dazchi/bx-tacho/firmware/README.md

# BX Tacho firmware

ESP-IDF **v6.1** firmware for the BX Tacho v0.2 board (ESP32-C3-WROOM-02).
Spec: `HANDOVER.md` section 6.

## Build and flash

In VS Code with the ESP-IDF extension, open **this `firmware/` folder** (not the
repo root), select the serial port of the board's USB Serial/JTAG, then run
**ESP-IDF: Build, Flash and Monitor**.

From an ESP-IDF terminal:

```
idf.py build
idf.py -p COMx flash monitor
```

If automatic download mode fails, hold BOOT (SW3), tap RESET (SW2), release BOOT.

`idf.py flash` writes the bootloader, the partition table, the app and a blank
`otadata`. Flashing by hand, write `otadata` with the app: with two app slots,
an app written alone at 0x10000 doesn't boot if the board last ran the other
slot.

```
python -m esptool --chip esp32c3 -p COMx -b 460800 write-flash 0x10000 build/bx-tacho.bin 0x10e000 build/ota_data_initial.bin
```

A board that still has the older single-app partition table needs the full set
once (`idf.py flash`, or the web app's USB update, which always writes it).

## Release build

The normal build is for debugging (`-Og`). A release is optimised for speed
(`-O2`, `sdkconfig.release` on top of `sdkconfig.defaults`) and built in its
own folder with its own sdkconfig, so the development build is untouched:

```
idf.py -B build/release -D SDKCONFIG=build/release/sdkconfig -D "SDKCONFIG_DEFAULTS=sdkconfig.defaults;sdkconfig.release" build
```

Every build also writes the files to publish, named after `PROJECT_VER` in
`CMakeLists.txt` (with `-bbp` for a build with the extension):

- `build/release/bx-tacho-v2.3.0.bin`: for updates from the web app (USB or
  Bluetooth) or `write-flash 0x10000` (with `otadata`, see above). A copy of
  `bx-tacho.bin`, which `idf.py flash` keeps using.
- `build/release/bx-tacho-v2.3.0-merged.bin`: everything from 0x0 (what
  `idf.py flash` writes), for a blank board (`write-flash 0x0`). It overwrites
  NVS (settings and shot history) but ends below `fctry`, so the battery
  calibration stays.

Options set by hand with `idf.py menuconfig` go into `firmware/sdkconfig`
only; for a release they belong in `sdkconfig.defaults` (or
`sdkconfig.release`). The release bootloader is the same as the development
one (only its build date differs), so `web/firmware/bootloader.bin` needn't
change for a release.

Tunables are under **BX Tacho** in `idf.py menuconfig` (`main/Kconfig.projbuild`).

## Layout

| File | Purpose |
|---|---|
| `main/board.h` | Pin map (HANDOVER.md 3.9) |
| `main/rpm.c` | RPM channel power sequencing, threshold PWM, edge-timestamp ISR |
| `main/load.c` | Load sensor: ambient-cancelled ADC reads, black/white launcher detection, calibrated hysteresis classifier |
| `main/launch.c` | EMPTY → LOADED → PULLING → RESULT state machine, peak RPM |
| `main/battery.c` | VBAT, USB presence, charge state |
| `main/display.c` | SSD1315 OLED via `esp_lcd`, framebuffer and 5×7 font |
| `main/settings.c` | Calibration stored in NVS |
| `main/bbp.c` | Battle Pass (BX-09) emulation over BLE and the shot history, see below |
| `main/cli.c` | Bring-up and calibration console |
| `main/ble_console.c` | The console over BLE (unlocked with a code on the display), see below |
| `main/ble_ota.c` | Firmware updates over BLE, see below |
| `main/main.c` | Tasks, light sleep, display dimming, deep sleep |

## Console (USB Serial/JTAG, or Bluetooth)

| Command | What it does |
|---|---|
| `status` | Battery, sensors, calibration, last launch |
| `diag on` / `diag off` | Pause the launch state machine so you can drive the sensors by hand |
| `meter on` / `meter off` | Continuous RPM mode for bench tests: RPM channel always on, display shows live RPM (1 s average, min/max, rejected edges) |
| `meter` / `meter log [s] [ms]` | Print meter readings as CSV, once or every `ms` for `s` seconds |
| `rpm on` / `rpm off` | Power the RPM channel (diag mode) |
| `rpm sense [n]` | Print RPM_SENSE in mV (channel must be on) |
| `rpm scan [black\|white] [s] [apply]` | Record RPM_SENSE min/max while you turn the launcher; `apply` saves the point 60 % of the way from the black to the white level as the named launcher's threshold (`apply` needs the launcher) |
| `rpm thr [black\|white <mV>]` | Show the comparator thresholds, or set one launcher's (capped at 2000 mV) |
| `load [n]` / `load flash [n]` | Print ambient-cancelled LOAD_SENSE readings; `flash` puts a full poll next to the short flash sample used while a top is loaded |
| `load led on\|off\|auto` | Hold the load LED on (diag or meter mode), to test its crosstalk into the RPM sensor, or off (no measurement flashes, only ambient light); `load` and the diag screen then show the raw LOAD_SENSE voltage. `auto` goes back to normal measurements, as does leaving diag or meter mode. `rpm scan` keeps it off while it samples. In normal use it is only flashed while the RPM channel is armed, as its light reflected off a loaded top reaches the RPM sensor: at each rising RPM edge while the disc turns, off again within 90 % of the disc's white part (so it can't make or move a rising edge), and every 10 ms while the disc is still |
| `cal load black\|white empty\|loaded\|clear` | Calibrate the load sensor for one launcher |
| `cal vbat start` … `stop` | Production VBAT calibration, see below |
| `cfg edges <n>` | Rising edges per launcher revolution |
| `cfg lightsleep on\|off` | Automatic light sleep on battery (default on), for power debugging |
| `cfg flip on\|off` | Turn the display 180 degrees, for holding the launcher in the other hand (default off; applies at once, kept by `cfg reset`) |
| `cfg autowhite on\|off` | Automatic white launcher detection (default on). Off: BX Tacho always uses the black launcher's settings, for anyone who only uses dark launchers (applies at once, kept by `cfg reset`) |
| `cfg ext on\|off` | Use the optional Battle Pass extension, in builds that have one (default off; saves and restarts), see "Optional extension" |
| `events` / `events clear` | Power/sleep event log: boots and reset reasons, load changes, launcher changes, state changes, USB, display on/off, deep sleep. Kept in RTC memory, so it survives deep sleep and resets (not power-on) |
| `launch [n]` | Last launch edge by edge (first `n` edges, default 60): time, interval, RPM, with the release seen by the load sensor and any edges the chatter filter dropped |
| `ble` | Battle Pass link state |
| `ble on\|off` | Battle Pass emulation and the BLE console (default on); saves and restarts |
| `history` / `history clear` | Shot history sent to Battle Pass apps; `clear` wipes the last 50 shots, the total count, the max and the latest curve |
| `sleep` | Deep sleep now |
| `id` | Serial number (the factory MAC from eFuse, unique per chip), Bluetooth address, the optional 128-bit eFuse unique ID (blank on some chips) and the chip revision |

Over USB, light sleep is disabled while a host is connected so the link
stays up. Ctrl-C stops `meter log`, `rpm scan`, `rpm sense` and `load`
(on USB, other keys typed while a command runs are dropped).

### Over Bluetooth

The same commands also run over BLE, from the web app's Bluetooth tab
(`web/`), without a cable: this is how the VBAT calibration runs with no USB
power. It is a GATT service of its own (`main/ble_console.h` has the UUIDs and
the protocol), next to the Battle Pass one.

- **Code:** on every connection, opening the console shows
  `BLUETOOTH CONSOLE` and a 6-digit code on the display, to type into the web
  app. Until then the console runs nothing, so only someone who can see the
  display can use it. A wrong code gets a new one after a second's delay, and a
  code expires after 2 minutes. There is no Bluetooth pairing: nothing is
  stored on either side, and the link isn't encrypted (someone nearby with a
  Bluetooth sniffer could read the console traffic, but can't run commands
  without the code). The Battle Pass service is unaffected.
- One command runs at a time: while USB runs one, Bluetooth gets a "busy" note,
  and the other way round.

## Bring-up order

1. `status`: check the battery reading and USB/charge state.
2. `diag on`, `rpm on`, `rpm sense`: confirm RPM_SENSE changes between black and white.
3. `rpm scan black 5 apply` while turning the launcher slowly. Aim for ≥ 200 mV contrast.
4. `diag off`. Count the launcher's black/white segments and set `cfg edges <n>`.
5. `cal load black empty` with no top attached, then `cal load black loaded` with one attached.
6. Launch and compare the peak RPM with a reference.
7. Repeat 3 and 5 on a launcher of the other colour (see below).

Without a load calibration the RPM channel stays armed all the time, so
launches are still measured; the display shows **ARMED** instead of **READY**.

### Black and white launchers

A launcher with a white housing reflects far more of the load LED's light
than a black one, so the same top reads very differently: on the prototype
about 100 / 300 mV (empty / loaded) on a black launcher and 490 / 750 mV on a
white one. Pushing the pin up by hand reads higher still (about 500 mV on
black, 1000 mV on white). Each kind keeps its own load calibration and RPM
threshold (`rpm thr black 80`, `rpm thr white 90`; 80 and 90 mV by default).

BX Tacho starts on the black launcher's settings and changes with two
thresholds taken from the calibrations:

- above the white launcher's **loaded** threshold (60 % of the way from its
  empty to its loaded level, 646 mV by default): white. Only a white
  launcher reads that high, with a top on it or its pin pushed up.
- below the black launcher's **released** threshold (40 %, 180 mV by
  default): black. Only a black launcher, or none, reads that low.
- in between (an empty white launcher, the pin pushed up on a black one): no
  change.

`cfg autowhite off` turns the detection off: BX Tacho then always uses the black
launcher's settings. Switching to white takes readings above its threshold for 3 s without a
break: a bey pushed in too far on a black launcher lifts the pin past it
for a moment before it drops back. Switching to black takes 4 readings in a
row. Neither happens during a launch. `events` logs each change; `status` and the diag screen show which launcher is in use.

On a white launcher, until the first reading above its loaded threshold (the
first top loaded, or the pin pushed up), BX Tacho is still on the black
settings and the empty white launcher reads as loaded. The calibration commands
always name the launcher (`cal load white empty`, `rpm scan white 5 apply`,
`rpm thr white 80`) for that reason.

Updating from 1.x resets the load and RPM calibration and `cfg edges` to
these defaults (one calibration for every launcher can't be carried over);
the display, BLE and light-sleep settings, the shot history and the battery
calibration are kept.

## Battle Pass emulation (BLE)

BX Tacho advertises as a Takara Tomy BEYBATTLE PASS (BX-09), `BEYBLADE_TOOL01`,
so third-party Battle Pass apps can connect and read launches. Protocol,
sources and open questions: [docs/bbp-protocol.md](docs/bbp-protocol.md).

- Loading a top and taking it off send the attach/detach status.
- Each launch adds its peak RPM to the history (last 50, plus lifetime count
  and max) and sends the history with the launch curve: the first 32
  revolutions from the start of the pull, including the spin-down.
- The history is kept in NVS (namespace `bbp`) and survives power cycles,
  deep sleep and `cfg reset`; `history clear` wipes it. It is recorded even with
  BLE off. Flashing the merged binary at 0x0 erases it, like the other NVS
  settings.
- Commands from the app: `0x51` status, `0x74` history and curve; anything
  else (including `0x75`, meaning unconfirmed) is logged and ignored.
- BLE runs alongside automatic light sleep (modem sleep, with the main crystal
  kept on), which raises the sleep current. `ble off` if you don't use an app.
  Deep sleep ends the connection; the app reconnects after a wake-up.
- **Switching BLE without a console:** put a top on and take it off 5 times in
  a row, each load within 1.5 s of the previous one. The display shows
  `BLE ON` or `BLE OFF`, then BX Tacho restarts with the new setting (same as
  `ble on|off`; logged as `BLE GESTURE` in `events`). Flashing the merged
  binary resets it to on.
- **Debug log:** connects, disconnects and subscriptions (with a session
  number), every write from the app, each status packet with its reason, and
  the start and end of each history/curve dump go to the USB log (tag `bbp`).
  Data meant for one session never reaches the next: queued commands and
  packets carry their session number.

## Optional extension

The Battle Pass emulation can take an extension: a component named `bbp_ext`
kept outside this repository, which can change how BX Tacho presents itself
and add to what it sends. The interface is
`components/bbp_ext_api/include/bbp_ext.h`; linking an extension that uses
only it is covered by the additional permission in `NOTICE`.

- Without one (the normal build, and the releases), none of it is compiled in
  and `cfg ext` says the build has none.
- A build with one: point `EXTRA_COMPONENT_DIRS` at the folder that holds
  `bbp_ext/`, in a build folder of its own:

  ```
  idf.py -B build/ext -D SDKCONFIG=build/ext/sdkconfig -D EXTRA_COMPONENT_DIRS=<folder with bbp_ext> build
  ```

  For a release build add `-D "SDKCONFIG_DEFAULTS=sdkconfig.defaults;sdkconfig.release"`.
- It's used only while `cfg ext on` (off by default, applied at boot) and only
  if it was built for the same interface version (`BBP_EXT_API_VERSION`);
  `ble` shows its name and whether it's in use.

## Firmware updates over Bluetooth

From the web app's Bluetooth tab: pick `bx-tacho-v<version>.bin` (or use the latest release), enter the code on the
display (as for the console), and BX Tacho takes the image in about a minute,
showing `FIRMWARE UPDATE` and the percentage, then restarts into it. Protocol:
`main/ble_ota.h`.

- `partitions.csv` has two app slots, `ota_0` (where the single app used to be)
  and `ota_1`, and `otadata`, which says which one boots. An update goes to the
  slot not running; the current firmware stays until the new image is complete
  and checked: valid for this chip (ESP-IDF's image and hash check) and project
  name `bx-tacho`. A dropped link, a bad file or a power cut leaves BX Tacho on
  its current firmware.
- **Rollback:** the new firmware is on probation until it has started all its
  tasks (end of `app_main`); a reset before that boots the previous firmware
  again (`CONFIG_BOOTLOADER_APP_ROLLBACK_ENABLE`).
- On battery it refuses unless the battery is above 50 % (plug in USB, or
  charge first). The display says `DO NOT TURN OFF` while it runs, and the web
  page asks before it's closed or reloaded.
- Settings, history and both calibrations are kept: NVS and `fctry` aren't in
  the app slots.
- Boards from before the two slots need one update over USB first (web app or
  `idf.py flash`); until then the web app says so.

## VBAT calibration (production)

Corrects the R3/R9 divider and ADC error (typically 10-40 mV) with a
straight-line fit. Run once per board.

**Setup**
- Power the board **only** from a bench supply on **J1** (pad 1 VBAT+,
  pad 2 GND), power switch ON, current limit about 300 mA, no battery.
- Run the console **over Bluetooth** (web app, Bluetooth tab) with USB
  unplugged, or connect USB **data-only** (VBUS cut, e.g. a USB power
  blocker). With VBUS present the TP4054 charger pushes current into J1 and
  spoils the reading; the firmware refuses to calibrate then.
- Read the voltage **at the J1 pads** with a multimeter, not on the supply.
- Stay within 3.2-4.4 V (the board runs from the supply; the ADC sees VBAT/2).

**Steps**
```
cal vbat start
cal vbat point 3300      # set supply, enter the multimeter reading (mV)
cal vbat point 3700
cal vbat point 4000
cal vbat point 4300
cal vbat save            # fit, check, store
cal vbat verify 3600     # different voltage; PASS within +-10 mV
cal vbat stop
```
`cal vbat show` (and `status`) print the stored calibration.

Calibration mode keeps the RPM channel and the load LED off and the chip
out of light sleep, so the current stays steady. While `point` or `verify`
measures (about 0.5 s) the display is also frozen: no redraws, no I2C
traffic. Bluetooth keeps running (it carries the console); over a data-only
USB connection, `ble off` takes its radio bursts away too.

The calibration lives in its own NVS partition (`fctry`, see
`partitions.csv`). `cfg reset` and NVS recovery never touch it; only a new
calibration or a full flash erase replaces it.

## License

GPL-3.0-or-later: see `LICENSE` and `NOTICE` in the repository root, which
also lists the few parts under other terms.
