dazchi/bx-tacho/hardware/bx-tacho.csv

Reference | Qty | Value | DNP | Exclude from BOM | Exclude from Board | Exclude from Simulation | Exclude from Position Files | Footprint | Datasheet
C1,C10 | 2 | 10uF |  |  |  |  | ${EXCLUDE_FROM_POS_FILES} | Capacitor_SMD:C_0805_2012Metric
C2,C3,C4,C9 | 4 | 1uF |  |  |  |  | ${EXCLUDE_FROM_POS_FILES} | Capacitor_SMD:C_0603_1608Metric
C5,C7,C11,C12 | 4 | 100nF |  |  |  |  | ${EXCLUDE_FROM_POS_FILES} | Capacitor_SMD:C_0603_1608Metric
C8 | 1 | 10nF |  |  |  |  | ${EXCLUDE_FROM_POS_FILES} | Capacitor_SMD:C_0603_1608Metric
D1 | 1 | B5819W_C2943878 |  |  |  |  | ${EXCLUDE_FROM_POS_FILES} | lib:SOD-123F_L2.7-W1.6-LS3.8-RD-1 | https://www.lcsc.com/datasheet/C2943878.pdf
D2 | 1 | LED |  |  |  |  | ${EXCLUDE_FROM_POS_FILES} | LED_SMD:LED_0603_1608Metric_Pad1.05x0.95mm_HandSolder
J1 | 1 | Conn_01x02 |  |  |  |  | ${EXCLUDE_FROM_POS_FILES} | lib:BatteryPads_1x02_SMD_2x3mm_P4mm
J2,J3 | 2 | Conn_01x04 |  |  |  |  | ${EXCLUDE_FROM_POS_FILES} | Connector_PinHeader_2.54mm:PinHeader_1x04_P2.54mm_Vertical
KEY1,KEY2 | 2 | ITR8307/S17/TR8 |  |  |  |  | ${EXCLUDE_FROM_POS_FILES} | lib:OPTO-SMD_ITR8307-S17-TR8-B-BL | https://lcsc.com/product-detail/Photo-Interrupter_ITR8307-S17-TR8-B_C81632.html
LDO1 | 1 | ME6211C33M5G-N |  |  |  |  | ${EXCLUDE_FROM_POS_FILES} | lib:SOT-23-5_L3.0-W1.7-P0.95-LS2.8-BL | https://lcsc.com/product-detail/Low-Dropout-Regulators-LDO_ME6211C33M5G-N_C82942.html
Q1 | 1 | AO3401A |  |  |  |  | ${EXCLUDE_FROM_POS_FILES} | Package_TO_SOT_SMD:SOT-23 | http://www.aosmd.com/pdfs/datasheet/AO3401A.pdf
R1,R2 | 2 | 5.1k |  |  |  |  | ${EXCLUDE_FROM_POS_FILES} | Resistor_SMD:R_0603_1608Metric
R3,R5,R13,R14,R15,R19,R21,R24,R25,R26 | 10 | 10k |  |  |  |  | ${EXCLUDE_FROM_POS_FILES} | Resistor_SMD:R_0603_1608Metric
R4,R11,R12 | 3 | 220 |  |  |  |  | ${EXCLUDE_FROM_POS_FILES} | Resistor_SMD:R_0603_1608Metric
R6,R8 | 2 | 100k |  |  |  |  | ${EXCLUDE_FROM_POS_FILES} | Resistor_SMD:R_0603_1608Metric
R7 | 1 | 68k |  |  |  |  | ${EXCLUDE_FROM_POS_FILES} | Resistor_SMD:R_0603_1608Metric
R9,R10 | 2 | 470k |  |  |  |  | ${EXCLUDE_FROM_POS_FILES} | Resistor_SMD:R_0603_1608Metric
R17 | 1 | 1M |  |  |  |  | ${EXCLUDE_FROM_POS_FILES} | Resistor_SMD:R_0603_1608Metric
SW1,SW2 | 2 | TS-1101-C-W |  |  |  |  | ${EXCLUDE_FROM_POS_FILES} | lib:SW-SMD_L6.0-W3.3-LS8.0_TS-1101-C-W | https://www.lcsc.com/datasheet/C318938.pdf
SW3 | 1 | SK-12D02-G060 |  |  |  |  | ${EXCLUDE_FROM_POS_FILES} | lib:SW-TH_SK-12D02-G060 | https://www.lcsc.com/datasheet/C2848884.pdf
TP1,TP2,TP3,TP4,TP5,TP7,TP8,TP9,TP10,TP11,TP12,TP13 | 12 | TestPoint |  |  |  |  | ${EXCLUDE_FROM_POS_FILES} | TestPoint:TestPoint_Pad_D1.0mm
U1 | 1 | ESP32-C3-WROOM-02 |  |  |  |  | ${EXCLUDE_FROM_POS_FILES} | RF_Module:ESP32-C3-WROOM-02 | https://www.espressif.com/sites/default/files/documentation/esp32-c3-wroom-02_datasheet_en.pdf
U2 | 1 | TP4054_C5381776 |  |  |  |  | ${EXCLUDE_FROM_POS_FILES} | lib:SOT-23-5_L2.9-W1.6-P0.95-LS2.8-BR | https://www.lcsc.com/datasheet/C5381776.pdf
U4 | 1 | HS96L03W2C03 |  |  |  |  | ${EXCLUDE_FROM_POS_FILES} | lib:OLED-TH_L27.8-W27.2-P2.54_C9900033791 | https://www.lcsc.com/datasheet/C5248080.pdf
U5 | 1 | LMV331IDBVR |  |  |  |  | ${EXCLUDE_FROM_POS_FILES} | lib:SOT-23-5_L3.0-W1.7-P0.95-LS2.8-BR | http://www.ti.com/lit/ds/symlink/lmv331.pdf
USB1 | 1 | TYPE-C 16PIN 2MD |  |  |  |  | ${EXCLUDE_FROM_POS_FILES} | lib:USB-C-SMD_TYPE-C-16PIN-2MD-073 | https://www.lcsc.com/datasheet/C2765186.pdf
