dazchi/bx-tacho/mechanical/board_outline_mount_hole.dxf

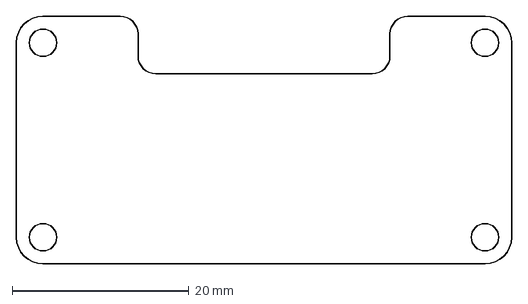
[picture p3: CAD file, 2026-10-04]
mechanical/board_outline_mount_hole.dxf
56.0 x 28.0 mm
