dazchi/bx-tacho/mechanical/board_outline.dxf

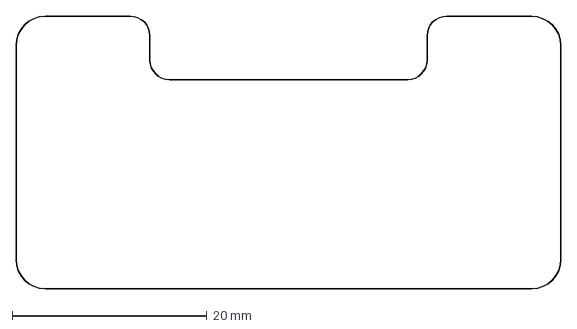
[picture p4: CAD file, 2026-10-04]
mechanical/board_outline.dxf
56.0 x 28.0 mm
