dazchi/bx-tacho/mechanical/board_outline_2mm_mount_hole.dxf

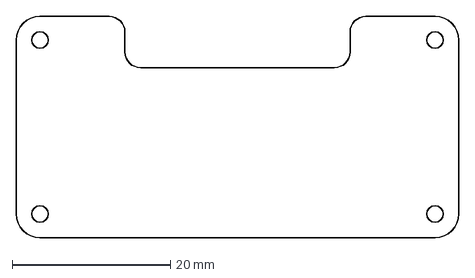
[picture p5: CAD file, 2026-10-04]
mechanical/board_outline_2mm_mount_hole.dxf
56.0 x 28.0 mm
