dazchi/bx-tacho/hardware/bx-tacho.kicad_pcb

## KiCad design hardware/bx-tacho.kicad_pcb (2026-10-24)

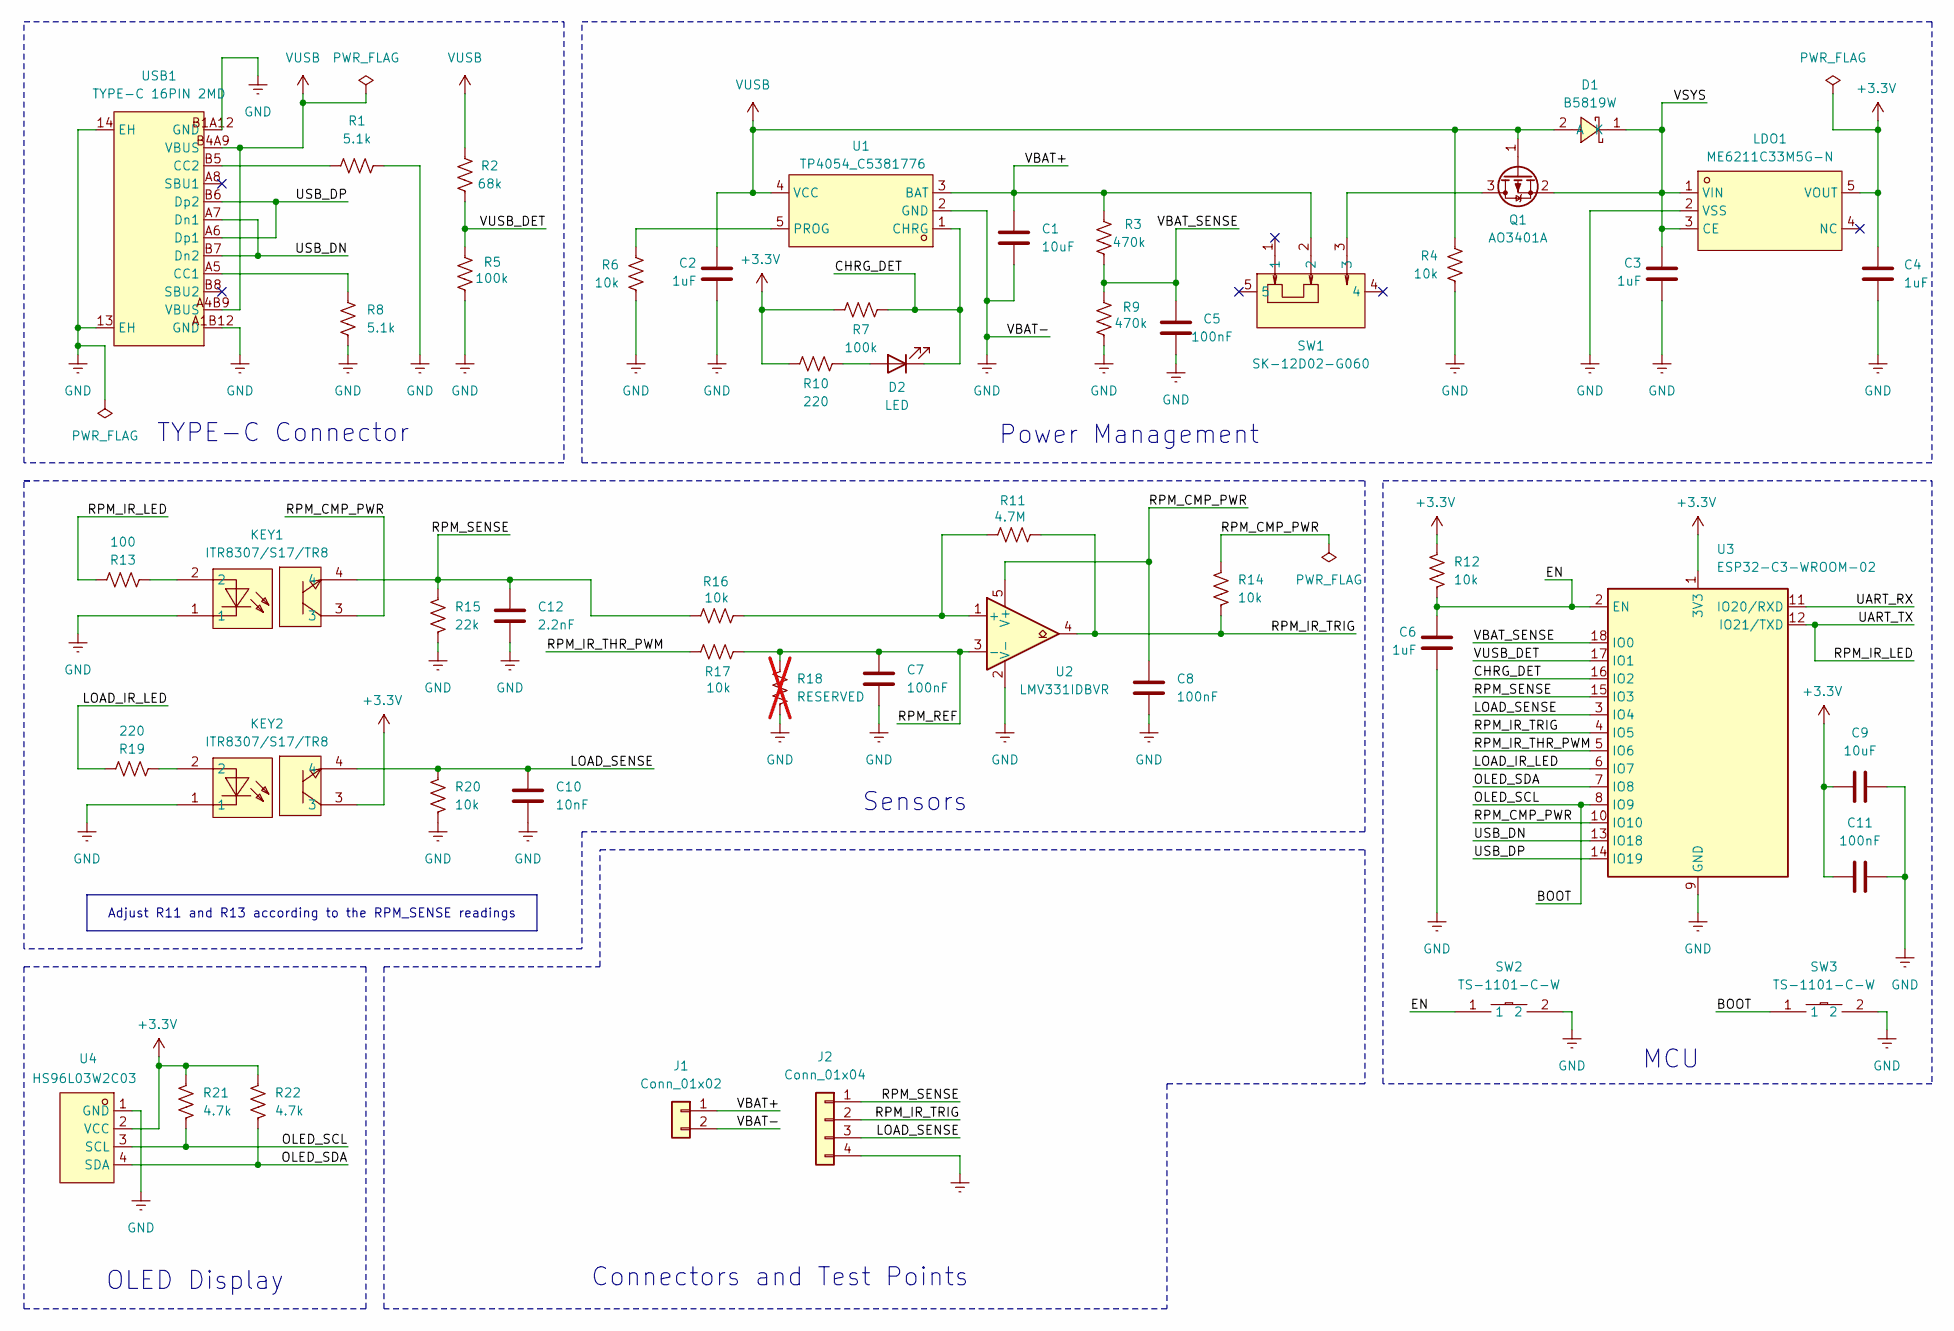
[picture p10: schematic bx-tacho.kicad_sch, BX Tacho]

Parts:
C1, C9: 10uF; C_0805_2012Metric; LCSC C15850
C2, C3, C4, C6: 1uF; C_0603_1608Metric; LCSC C15849
C5, C7, C8, C11: 100nF; C_0603_1608Metric; LCSC C14663
C10: 10nF; C_0603_1608Metric; LCSC C57112
C12: 2.2nF; C_0603_1608Metric; LCSC C1604
D1: B5819W; SOD-123F_L2.7-W1.6-LS3.8-RD-1; MPN B5819W SL; LCSC Part C8598
D2: LED; LED_0603_1608Metric_Pad1.05x0.95mm_HandSolder; LCSC C2286
J1: Conn_01x02; BatteryPads_1x02_SMD_2x3mm_P4mm
J2: Conn_01x04; PinHeader_1x04_P2.54mm_Vertical
KEY1, KEY2: ITR8307/S17/TR8; OPTO-SMD_ITR8307-S17-TR8-B-BL; MPN ITR8307/S17/TR8(B); LCSC Part C81632
LDO1: ME6211C33M5G-N; SOT-23-5_L3.0-W1.7-P0.95-LS2.8-BL; MPN ME6211C33M5G-N; LCSC Part C82942
Q1: AO3401A; SOT-23; LCSC C15127
R1, R8: 5.1k; R_0603_1608Metric; LCSC C23186
R2: 68k; R_0603_1608Metric; LCSC C23231
R3, R9: 470k; R_0603_1608Metric; LCSC C23178
R4, R6, R12, R14, R16, R17, R20: 10k; R_0603_1608Metric; LCSC C25804
R5, R7: 100k; R_0603_1608Metric; LCSC C25803
R10, R19: 220; R_0603_1608Metric; LCSC C22962
R11: 4.7M; R_0603_1608Metric; LCSC C2930153
R13: 100; R_0603_1608Metric; LCSC C22775
R15: 22k; R_0603_1608Metric; LCSC C31850
R18: RESERVED; R_0603_1608Metric; not fitted
R21, R22: 4.7k; R_0603_1608Metric; LCSC C23162
SW1: SK-12D02-G060; SW-TH_SK-12D02-G060; MPN SK-12D02-G060; LCSC Part C2848884
SW2, SW3: TS-1101-C-W; SW-SMD_L6.0-W3.3-LS8.0_TS-1101-C-W; MPN TS-1101-C-W; LCSC Part C318938
U1: TP4054_C5381776; SOT-23-5_L2.9-W1.6-P0.95-LS2.8-BR; MPN TP4054; LCSC Part C5381776
U2: LMV331IDBVR; SOT-23-5_L3.0-W1.7-P0.95-LS2.8-BR; LCSC Part C34731
U3: ESP32-C3-WROOM-02; LCSC C2934560
U4: HS96L03W2C03; OLED-TH_L27.8-W27.2-P2.54_C9900033791; MPN HS96L03W2C03; LCSC Part C5248080
USB1: TYPE-C 16PIN 2MD; USB-C-SMD_TYPE-C-16PIN-2MD-073; MPN TYPE-C 16PIN 2MD(073); LCSC Part C2765186

Connections:
+3.3V: C4.1, C9.2, C11.2, KEY2.3, LDO1.5 (VOUT), R7.1, R10.1, R12.1, R21.1, R22.1, U3.1 (3V3), U4.2 (VCC)
/BOOT: R21.2, SW3.1, U3.8 (IO9), U4.3 (SCL)
/CHRG_DET: D2.1 (K), R7.2, U1.1 (CHRG), U3.16 (IO2)
/EN: C6.1, R12.2, SW2.1, U3.2 (EN)
/LOAD_IR_LED: R19.2, U3.6 (IO7)
/LOAD_SENSE: C10.1, J2.3, KEY2.4, R20.1, U3.3 (IO4)
/OLED_SDA: R22.2, U3.7 (IO8), U4.4 (SDA)
/RPM_CMP_PWR: C8.1, KEY1.3, R14.1, U2.5 (V+), U3.10 (IO10)
/RPM_IR_LED: R13.2, U3.12 (IO21/TXD)
/RPM_IR_THR_PWM: R17.2, U3.5 (IO6)
/RPM_IR_TRIG: J2.2, R11.1, R14.2, U2.4, U3.4 (IO5)
/RPM_REF: C7.1, R17.1, R18.1, U2.3 (-)
/RPM_SENSE: C12.1, J2.1, KEY1.4, R15.1, R16.2, U3.15 (IO3)
/UART_RX: U3.11 (IO20/RXD)
/USB_DN: U3.13 (IO18), USB1.A7 (Dn1), USB1.B7 (Dn2)
/USB_DP: U3.14 (IO19), USB1.A6 (Dp1), USB1.B6 (Dp2)
/VBAT+: C1.1, J1.1, R3.2, SW1.2, U1.3 (BAT)
/VBAT_SENSE: C5.1, R3.1, R9.2, U3.18 (IO0)
/VSYS: C3.1, D1.1 (K), LDO1.1 (VIN), LDO1.3 (CE), Q1.2 (S)
/VUSB_DET: R2.1, R5.2, U3.17 (IO1)
GND: C1.2, C2.2, C3.2, C4.2, C5.2, C6.2, C7.2, C8.2, C9.1, C10.2, C11.1, C12.2, J1.2, J2.4, KEY1.1, KEY2.1, LDO1.2 (VSS), R1.2, R4.2, R5.1, R6.2, R8.2, R9.1, R15.2, R18.2, R20.2, SW2.2, SW3.2, U1.2 (GND), U2.2 (V-), U3.9 (GND), U3.19 (GND), U4.1 (GND), USB1.13 (EH), USB1.14 (EH), USB1.A1B12 (GND), USB1.B1A12 (GND)
unnamed: D2.2 (A), R10.2
unnamed: KEY1.2, R13.1
unnamed: KEY2.2, R19.1
unnamed: Q1.3 (D), SW1.3
unnamed: R6.1, U1.5 (PROG)
unnamed: R11.2, R16.1, U2.1 (+)
unnamed: R8.1, USB1.A5 (CC1)
unnamed: R1.1, USB1.B5 (CC2)
VUSB: C2.1, D1.2 (A), Q1.1 (G), R2.2, R4.1, U1.4 (VCC), USB1.A4B9 (VBUS), USB1.B4A9 (VBUS)

Notes on the sheet:
MCU
Sensors
TYPE-C Connector
Connectors and Test Points
Power Management
OLED Display
Adjust R11 and R13 according to the RPM_SENSE readings

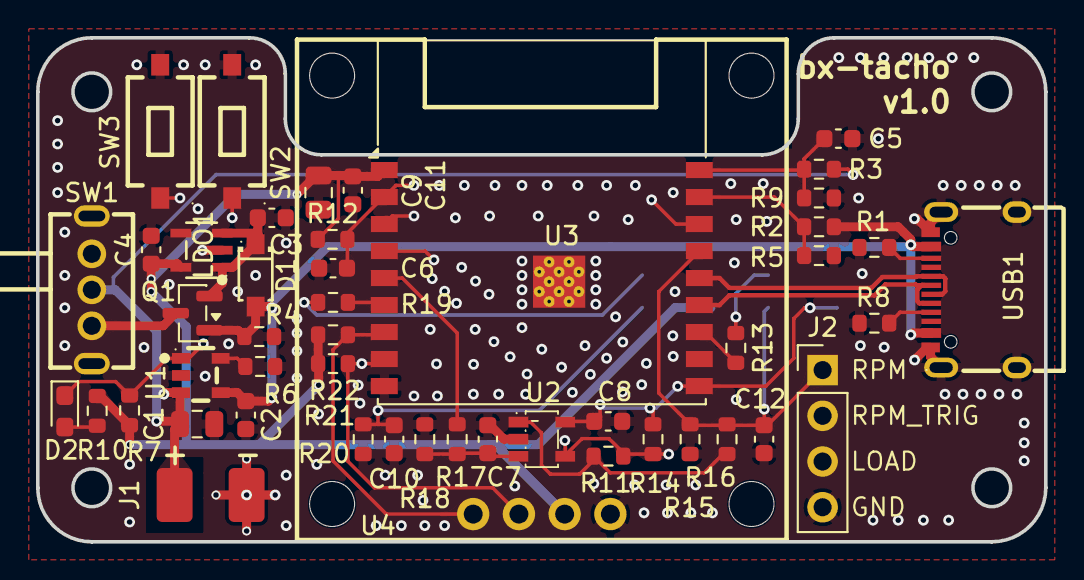
[picture p11: board bx-tacho.kicad_pcb from above]

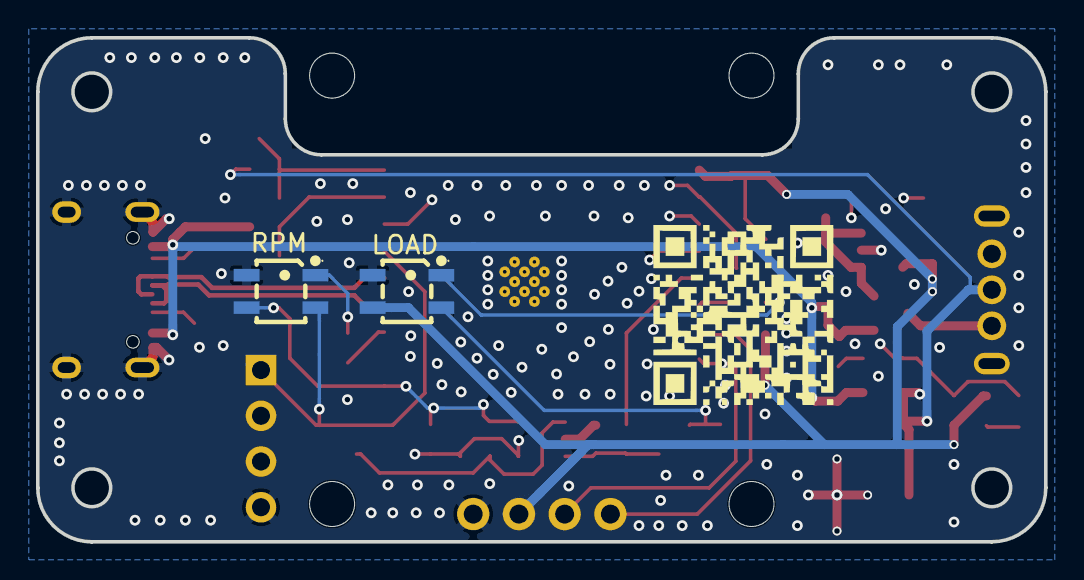
[picture p12: board bx-tacho.kicad_pcb from below]

Board: 4 copper layers, 56.0 x 28.0 mm, 50 parts (2 on the bottom side), 29 nets.
