dazchi/bx-tacho/firmware/main/launch.c

// SPDX-License-Identifier: GPL-3.0-or-later
// Copyright (C) 2026 Darren Chi
#include "launch.h"

#include "esp_log.h"
#include "esp_timer.h"
#include "rpm.h"
#include "settings.h"

static const char *TAG = "launch";

// Launch start: 3 edges within 200 ms. Launch end: 250 ms without an edge.
#define START_EDGES       3
#define START_WINDOW_US   200000
#define END_GAP_US        250000

// A launch whose last revolution is this much slower than its fastest one
// was a pull that faded out rather than a release.
#define SLOWDOWN_RATIO    2

#define MAX_EDGES         4096

// Chatter filter. Besides the absolute floor (CONFIG_BXT_MAX_RPM), an edge is
// dropped when it arrives sooner than CONFIG_BXT_CHATTER_RATIO_PCT of the
// recent edge interval: the disc cannot speed up that much within one
// interval, but chatter at the opposite transition lands about half an
// interval after a real edge. Assumes evenly spaced segments.
#define HIST_LEN            3
// A gap this much longer than the reference is a missed edge (or the disc
// slowing sharply); it is not used as a reference so the filter cannot lock
// onto half speed.
#define MISSED_EDGE_PCT     170
// The relative check only runs once the disc is past this speed. Starting from
// rest, a pull can double its speed within one revolution: with slow edges from
// before the pull as the reference, every other real edge then looked "too
// soon", and the filter locked onto half speed for the whole launch. From about
// 3000 rpm the speed changes far less than the CONFIG_BXT_CHATTER_RATIO_PCT
// margin per revolution.
#define RELATIVE_MIN_RPM    3000
// Once a launch has been past it, the check stays on as the disc slows down
// below it again: spinning down, the disc can't speed up either, and chatter
// on the slow edges at the end of a launch otherwise got through (one edge a
// few ms after a real one showed as about 20000 rpm on the live display).
// Lock recovery. The relative check can still take real edges for chatter, e.g.
// when edges the sensor missed early in a pull leave doubled intervals as the
// reference: every other real edge then looks too soon, half-way through the
// interval. LOCK_STREAK intervals in a row that each hold exactly one dropped
// edge within LOCK_MID_*_PCT of their middle are taken as a lock: those edges
// are put back and the filter starts again.
#define LOCK_STREAK         3
#define LOCK_MID_MIN_PCT    30
#define LOCK_MID_MAX_PCT    70

// Meter mode: average over this window; report 0 RPM after this long without an edge
#define METER_WINDOW_US     1000000
#define METER_TIMEOUT_US    2000000

static launch_state_t s_state = LAUNCH_EMPTY;

static uint32_t s_edges[MAX_EDGES];
static int s_num_edges;

static uint32_t s_window[START_EDGES];
static int s_window_len;

static uint32_t s_last_edge;
static bool s_have_last_edge;

static uint32_t s_int_rej_us;       // edge dropped as "too soon" in the current interval
static int s_int_rej_count;         // ...and how many
static uint32_t s_lock_rej[LOCK_STREAK];   // such edges of the last intervals in a row
static int s_lock_streak;
static int s_lock_recoveries;       // in this launch

static uint32_t s_hist[HIST_LEN];   // recent accepted edge intervals (us)
static int s_hist_len;
static int s_hist_next;
static int s_long_streak;           // consecutive gaps rejected as references
static bool s_relative_on;          // this launch has passed RELATIVE_MIN_RPM: keep the check
static uint32_t s_last_gap_us;      // between the last two accepted edges, 0 none
static int s_rejected_max_rpm;      // edges dropped in this launch: faster than CONFIG_BXT_MAX_RPM
static int s_rejected_relative;     // ...or too soon for the recent interval

static uint32_t s_meter_count;      // meter mode: accepted edges, stored in s_edges as a ring

static bool s_was_loaded;
static bool s_release_seen;
static uint32_t s_release_us;

static launch_result_t s_result;
static bool s_have_result;
static uint32_t s_curve[LAUNCH_CURVE_MAX];
static int s_curve_len;

// Edges the filter dropped during the current/last launch, for the console trace
static uint32_t s_rej_us[LAUNCH_TRACE_REJECTS];
static bool s_rej_max_rpm[LAUNCH_TRACE_REJECTS];
static int s_num_rej;

static inline bool time_before_eq(uint32_t a, uint32_t b)
{
    return (int32_t)(a - b) <= 0;
}

static int period_to_rpm(uint32_t period_us)
{
    return period_us ? (int)(60000000ULL / period_us) : 0;
}

const char *launch_state_name(launch_state_t s)
{
    switch (s) {
    case LAUNCH_EMPTY:   return "EMPTY";
    case LAUNCH_LOADED:  return "LOADED";
    case LAUNCH_PULLING: return "PULLING";
    case LAUNCH_RESULT:  return "RESULT";
    }
    return "?";
}

static void set_state(launch_state_t s)
{
    if (s != s_state) {
        ESP_LOGI(TAG, "%s -> %s", launch_state_name(s_state), launch_state_name(s));
        s_state = s;
    }
}

static void filter_reset(void)
{
    s_hist_len = 0;
    s_hist_next = 0;
    s_long_streak = 0;
    s_int_rej_count = 0;
    s_lock_streak = 0;
}

// Reference interval for the relative filter, or 0 until enough history.
// min(last, median) follows a speed-up immediately and ignores one long gap.
static uint32_t filter_reference(void)
{
    if (s_hist_len < HIST_LEN) {
        return 0;
    }
    uint32_t a = s_hist[0], b = s_hist[1], c = s_hist[2];
    uint32_t lo = a < b ? (a < c ? a : c) : (b < c ? b : c);
    uint32_t hi = a > b ? (a > c ? a : c) : (b > c ? b : c);
    uint32_t median = a + b + c - lo - hi;
    uint32_t last = s_hist[(s_hist_next + HIST_LEN - 1) % HIST_LEN];
    return last < median ? last : median;
}

static void filter_record(uint32_t gap, uint32_t ref)
{
    if (ref && (uint64_t)gap * 100 > (uint64_t)ref * MISSED_EDGE_PCT) {
        // Likely a missed edge. Only if it keeps happening has the rhythm
        // really changed; then start the history again from here.
        if (++s_long_streak < HIST_LEN) {
            return;
        }
        filter_reset();
    }
    s_long_streak = 0;
    s_hist[s_hist_next] = gap;
    s_hist_next = (s_hist_next + 1) % HIST_LEN;
    if (s_hist_len < HIST_LEN) {
        s_hist_len++;
    }
}

void launch_init(void)
{
    s_state = LAUNCH_EMPTY;
    s_window_len = 0;
    s_have_last_edge = false;
    filter_reset();
}

static void start_launch(void)
{
    s_num_edges = 0;
    for (int i = 0; i < s_window_len; i++) {
        s_edges[s_num_edges++] = s_window[i];
    }
    s_window_len = 0;
    s_release_seen = false;
    s_relative_on = false;
    s_rejected_max_rpm = 0;
    s_rejected_relative = 0;
    s_num_rej = 0;
    s_lock_recoveries = 0;
    set_state(LAUNCH_PULLING);
}

// Returns false if the launch was too short to count
static bool finish_launch(void)
{
    int epr = settings_get()->edges_per_rev;

    // End the window at the release if the load sensor saw one: the launcher
    // mechanism keeps turning briefly after the top has left. Keep the two
    // revolutions that end next: the sensor reports the release a few ms late
    // (debounce), and a short pull may have only one fast revolution before it,
    // while the peak below needs three.
    int n = s_num_edges;
    if (s_release_seen) {
        while (n > 0 && !time_before_eq(s_edges[n - 1], s_release_us)) {
            n--;
        }
        n = n + 2 * epr < s_num_edges ? n + 2 * epr : s_num_edges;
    }
    if (n <= epr) {
        return false;
    }

    // Three fastest revolutions; the peak is their median (rejects a single glitch)
    uint32_t best[3] = {UINT32_MAX, UINT32_MAX, UINT32_MAX};
    for (int i = epr; i < n; i++) {
        uint32_t p = s_edges[i] - s_edges[i - epr];
        if (p < best[0]) {
            best[2] = best[1];
            best[1] = best[0];
            best[0] = p;
        } else if (p < best[1]) {
            best[2] = best[1];
            best[1] = p;
        } else if (p < best[2]) {
            best[2] = p;
        }
    }
    int periods = n - epr;
    uint32_t median = periods >= 3 ? best[1] : best[0];
    uint32_t last = s_edges[n - 1] - s_edges[n - 1 - epr];

    s_result = (launch_result_t) {
        .peak_rpm = period_to_rpm(median),
        .max_rpm = period_to_rpm(best[0]),
        .revolutions = (n - 1) / epr,
        .duration_ms = (int)((s_edges[n - 1] - s_edges[0]) / 1000),
        .end = s_release_seen ? LAUNCH_END_RELEASE
             : (last > best[0] * SLOWDOWN_RATIO ? LAUNCH_END_SLOWDOWN : LAUNCH_END_ABRUPT),
        .rejected_max_rpm = s_rejected_max_rpm,
        .rejected_relative = s_rejected_relative,
    };
    s_have_result = true;

    // Whole revolutions from the first edge of the pull, over every edge (not
    // cut at the release), so the curve rises to the peak and then falls
    s_curve_len = 0;
    for (int i = epr; i < s_num_edges && s_curve_len < LAUNCH_CURVE_MAX; i += epr) {
        s_curve[s_curve_len++] = s_edges[i] - s_edges[i - epr];
    }

    ESP_LOGI(TAG, "peak %d rpm, max %d rpm, %d revs, %d ms, end=%d, rejected %d (max-rpm %d, relative %d)",
             s_result.peak_rpm, s_result.max_rpm, s_result.revolutions, s_result.duration_ms,
             s_result.end, s_result.rejected_max_rpm + s_result.rejected_relative,
             s_result.rejected_max_rpm, s_result.rejected_relative);
    return true;
}

static uint32_t min_edge_gap_us(void)
{
    return 60000000UL / ((uint32_t)CONFIG_BXT_MAX_RPM * settings_get()->edges_per_rev);
}

// Longest edge interval at which the relative check applies (RELATIVE_MIN_RPM)
static uint32_t relative_max_ref_us(void)
{
    return 60000000UL / ((uint32_t)RELATIVE_MIN_RPM * settings_get()->edges_per_rev);
}

// Puts an edge back into the launch record, in time order
static void restore_edge(uint32_t t)
{
    if (s_num_edges >= MAX_EDGES) {
        return;
    }
    int i = s_num_edges;
    while (i > 0 && !time_before_eq(s_edges[i - 1], t)) {
        s_edges[i] = s_edges[i - 1];
        i--;
    }
    s_edges[i] = t;
    s_num_edges++;

    // No longer a dropped edge in the console trace
    for (int k = 0; k < s_num_rej; k++) {
        if (s_rej_us[k] == t && !s_rej_max_rpm[k]) {
            for (; k + 1 < s_num_rej; k++) {
                s_rej_us[k] = s_rej_us[k + 1];
                s_rej_max_rpm[k] = s_rej_max_rpm[k + 1];
            }
            s_num_rej--;
            break;
        }
    }
}

// Called for each accepted edge t, `gap` after the previous one. Returns true
// when the filter has locked onto a fraction of the real speed (LOCK_STREAK).
static bool lock_detected(uint32_t gap)
{
    bool mid = false;
    if (s_int_rej_count == 1) {
        uint64_t pos = (uint64_t)(s_int_rej_us - s_last_edge) * 100;
        mid = pos >= (uint64_t)gap * LOCK_MID_MIN_PCT && pos <= (uint64_t)gap * LOCK_MID_MAX_PCT;
    }
    s_int_rej_count = 0;
    if (!mid) {
        s_lock_streak = 0;
        return false;
    }
    s_lock_rej[s_lock_streak++] = s_int_rej_us;
    if (s_lock_streak < LOCK_STREAK) {
        return false;
    }
    s_lock_streak = 0;
    return true;
}

// Chatter filter shared by launches and the meter. Returns false if the edge
// is dropped.
static bool accept_edge(uint32_t t, uint32_t min_gap_us)
{
    if (s_have_last_edge) {
        uint32_t gap = t - s_last_edge;
        if (gap > END_GAP_US) {
            filter_reset();   // the disc stopped; the old rhythm no longer applies
            s_relative_on = false;
            s_last_gap_us = 0;
        }
        uint32_t ref = filter_reference();
        bool fast = ref && ref <= relative_max_ref_us();
        if (fast && s_state == LAUNCH_PULLING) {
            s_relative_on = true;
        }
        uint32_t rel_limit = (fast || (s_relative_on && s_state == LAUNCH_PULLING))
            ? (uint32_t)((uint64_t)ref * CONFIG_BXT_CHATTER_RATIO_PCT / 100) : 0;
        // Faster than physically possible, or too soon after the last edge: chatter
        if (gap < min_gap_us || gap < rel_limit) {
            bool max_rpm = gap < min_gap_us;
            if (max_rpm) {
                s_rejected_max_rpm++;
            } else {
                s_rejected_relative++;
                s_int_rej_us = t;
                s_int_rej_count++;
            }
            if (s_state == LAUNCH_PULLING && s_num_rej < LAUNCH_TRACE_REJECTS) {
                s_rej_us[s_num_rej] = t;
                s_rej_max_rpm[s_num_rej] = max_rpm;
                s_num_rej++;
            }
            return false;
        }
        if (lock_detected(gap)) {
            // The dropped edges were real: put them back and start the filter
            // again from the true rhythm (the last restored edge to this one)
            uint32_t last_restored = s_lock_rej[LOCK_STREAK - 1];
            if (s_state == LAUNCH_PULLING) {
                for (int i = 0; i < LOCK_STREAK; i++) {
                    restore_edge(s_lock_rej[i]);
                }
            }
            s_rejected_relative -= LOCK_STREAK;
            s_lock_recoveries++;
            filter_reset();
            filter_record(t - last_restored, 0);
            ESP_LOGW(TAG, "edge filter was locked onto a fraction of the speed; %d edges restored",
                     LOCK_STREAK);
        } else {
            filter_record(gap, ref);
        }
        s_last_gap_us = gap <= END_GAP_US ? gap : 0;
    }
    s_last_edge = t;
    s_have_last_edge = true;
    return true;
}

static void handle_edge(uint32_t t, bool can_start, uint32_t min_gap_us)
{
    if (!accept_edge(t, min_gap_us)) {
        return;
    }

    if (s_state == LAUNCH_PULLING) {
        if (s_num_edges < MAX_EDGES) {
            s_edges[s_num_edges++] = t;
        }
        return;
    }
    if (!can_start) {
        s_window_len = 0;
        return;
    }

    // Slide the start window
    if (s_window_len == START_EDGES) {
        for (int i = 1; i < START_EDGES; i++) {
            s_window[i - 1] = s_window[i];
        }
        s_window_len--;
    }
    s_window[s_window_len++] = t;
    if (s_window_len == START_EDGES && (t - s_window[0]) <= START_WINDOW_US) {
        start_launch();
    }
}

void launch_new_launcher(void)
{
    s_was_loaded = false;
}

uint32_t launch_edge_interval_us(void)
{
    return s_last_gap_us;
}

bool launch_update(bool loaded, bool armed_always)
{
    launch_state_t prev = s_state;
    uint32_t now = (uint32_t)esp_timer_get_time();

    // Load transitions
    if (loaded && !s_was_loaded && s_state != LAUNCH_PULLING) {
        set_state(LAUNCH_LOADED);
    } else if (!loaded && s_was_loaded) {
        if (s_state == LAUNCH_PULLING && !s_release_seen) {
            s_release_seen = true;
            s_release_us = now;
        } else if (s_state == LAUNCH_LOADED) {
            set_state(LAUNCH_EMPTY);
        }
    }
    s_was_loaded = loaded;

    bool can_start = armed_always || s_state == LAUNCH_LOADED;
    bool want_power = can_start || loaded || s_state == LAUNCH_PULLING;
    if (want_power != rpm_is_powered()) {
        rpm_power(want_power);
        s_window_len = 0;
        s_have_last_edge = false;
        s_last_gap_us = 0;
        filter_reset();
    }

    uint32_t min_gap_us = min_edge_gap_us();
    uint32_t edges[32];
    int n;
    while ((n = rpm_take_edges(edges, 32)) > 0) {
        for (int i = 0; i < n; i++) {
            handle_edge(edges[i], can_start, min_gap_us);
        }
    }

    if (s_state == LAUNCH_PULLING && (now - s_last_edge) > END_GAP_US) {
        if (finish_launch()) {
            set_state(LAUNCH_RESULT);
        } else {
            set_state(loaded ? LAUNCH_LOADED : LAUNCH_EMPTY);
        }
    }

    return s_state != prev || s_state == LAUNCH_PULLING;
}

void launch_meter_start(void)
{
    s_state = LAUNCH_EMPTY;
    s_window_len = 0;
    s_have_last_edge = false;
    filter_reset();
    s_meter_count = 0;
    s_rejected_max_rpm = 0;
    s_rejected_relative = 0;
}

static inline uint32_t meter_edge(uint32_t i)
{
    return s_edges[i % MAX_EDGES];
}

void launch_meter_update(meter_stats_t *out)
{
    uint32_t epr = settings_get()->edges_per_rev;
    uint32_t min_gap_us = min_edge_gap_us();
    uint32_t edges[32];
    int n;
    while ((n = rpm_take_edges(edges, 32)) > 0) {
        for (int i = 0; i < n; i++) {
            if (accept_edge(edges[i], min_gap_us)) {
                s_edges[s_meter_count % MAX_EDGES] = edges[i];
                s_meter_count++;
            }
        }
    }

    *out = (meter_stats_t) {
        .edges = s_meter_count,
        .rejected_max_rpm = s_rejected_max_rpm,
        .rejected_relative = s_rejected_relative,
    };

    // Edges still held in the ring, and how far back from the newest one we can go
    uint32_t held = s_meter_count < MAX_EDGES ? s_meter_count : MAX_EDGES;
    if (held <= epr) {
        return;
    }
    uint32_t newest = s_meter_count - 1;
    uint32_t t_last = meter_edge(newest);
    if ((uint32_t)esp_timer_get_time() - t_last > METER_TIMEOUT_US) {
        return;   // stopped
    }

    // Whole revolutions within the window, but at least one when turning slowly
    uint32_t steps = 0;
    while (steps < held - 1 && t_last - meter_edge(newest - steps - 1) <= METER_WINDOW_US) {
        steps++;
    }
    steps -= steps % epr;
    if (steps == 0) {
        steps = epr;
    }

    uint32_t revs = steps / epr;
    uint32_t span = t_last - meter_edge(newest - steps);
    uint32_t slowest = 0;
    uint32_t fastest = UINT32_MAX;
    for (uint32_t back = 0; back + epr <= steps; back++) {
        uint32_t p = meter_edge(newest - back) - meter_edge(newest - back - epr);
        slowest = p > slowest ? p : slowest;
        fastest = p < fastest ? p : fastest;
    }

    out->revs = (int)revs;
    out->avg_rpm = span ? (int)(60000000ULL * revs / span) : 0;
    out->inst_rpm = period_to_rpm(t_last - meter_edge(newest - epr));
    out->min_rpm = period_to_rpm(slowest);
    out->max_rpm = period_to_rpm(fastest);
}

launch_state_t launch_get_state(void)
{
    return s_state;
}

bool launch_released(void)
{
    return s_state == LAUNCH_PULLING && s_release_seen;
}

int launch_live_rpm(void)
{
    int epr = settings_get()->edges_per_rev;
    if (s_state != LAUNCH_PULLING || s_num_edges <= epr) {
        return 0;
    }
    return period_to_rpm(s_edges[s_num_edges - 1] - s_edges[s_num_edges - 1 - epr]);
}

bool launch_get_result(launch_result_t *out)
{
    if (s_have_result) {
        *out = s_result;
    }
    return s_have_result;
}

bool launch_get_trace(uint32_t *edges, int max, launch_trace_t *info)
{
    if (!s_have_result || s_state == LAUNCH_PULLING) {
        return false;
    }
    int n = s_num_edges < max ? s_num_edges : max;
    for (int i = 0; i < n; i++) {
        edges[i] = s_edges[i];
    }
    info->num_edges = s_num_edges;
    info->release_seen = s_release_seen;
    info->release_us = s_release_us;
    info->num_rejected = s_num_rej;
    info->lock_recoveries = s_lock_recoveries;
    for (int i = 0; i < s_num_rej; i++) {
        info->rejected_us[i] = s_rej_us[i];
        info->rejected_max_rpm[i] = s_rej_max_rpm[i];
    }
    return true;
}

int launch_get_curve(uint32_t *periods_us, int max)
{
    int n = s_curve_len < max ? s_curve_len : max;
    for (int i = 0; i < n; i++) {
        periods_us[i] = s_curve[i];
    }
    return n;
}
