dazchi/bx-tacho/firmware/main/settings.c

// SPDX-License-Identifier: GPL-3.0-or-later
// Copyright (C) 2026 Darren Chi
#include "settings.h"

#include <string.h>
#include "esp_check.h"
#include "esp_log.h"
#include "nvs.h"
#include "nvs_flash.h"
#include "rpm.h"

static const char *TAG = "settings";

#define NVS_NAMESPACE "bxt"
#define NVS_KEY       "settings"
// Kept outside the settings blob so adding it did not invalidate saved calibration
#define NVS_KEY_LIGHT_SLEEP "lightsleep"
#define NVS_KEY_BLE         "ble"
#define NVS_KEY_FLIP        "flip"
#define NVS_KEY_BBP_EXT     "bbpext"
#define NVS_KEY_AUTO_WHITE  "autowhite"
// Bump when settings_t changes layout; stale blobs are then ignored.
#define SETTINGS_VERSION 2

typedef struct {
    uint32_t version;
    settings_t s;
} settings_blob_t;

static settings_t s_settings;
static bool s_light_sleep = true;
static bool s_ble = true;
static bool s_flip;
static bool s_auto_white = true;
static bool s_bbp_ext;

static esp_err_t save_u8(const char *key, uint8_t value)
{
    nvs_handle_t h;
    ESP_RETURN_ON_ERROR(nvs_open(NVS_NAMESPACE, NVS_READWRITE, &h), TAG, "open");
    esp_err_t err = nvs_set_u8(h, key, value);
    if (err == ESP_OK) {
        err = nvs_commit(h);
    }
    nvs_close(h);
    return err;
}

bool settings_light_sleep(void)
{
    return s_light_sleep;
}

esp_err_t settings_set_light_sleep(bool enable)
{
    s_light_sleep = enable;
    return save_u8(NVS_KEY_LIGHT_SLEEP, enable ? 1 : 0);
}

bool settings_ble(void)
{
    return s_ble;
}

esp_err_t settings_set_ble(bool enable)
{
    s_ble = enable;
    return save_u8(NVS_KEY_BLE, enable ? 1 : 0);
}

bool settings_flip(void)
{
    return s_flip;
}

esp_err_t settings_set_flip(bool flip)
{
    s_flip = flip;
    return save_u8(NVS_KEY_FLIP, flip ? 1 : 0);
}

bool settings_auto_white(void)
{
    return s_auto_white;
}

esp_err_t settings_set_auto_white(bool on)
{
    s_auto_white = on;
    return save_u8(NVS_KEY_AUTO_WHITE, on ? 1 : 0);
}

bool settings_bbp_ext(void)
{
    return s_bbp_ext;
}

esp_err_t settings_set_bbp_ext(bool on)
{
    s_bbp_ext = on;
    return save_u8(NVS_KEY_BBP_EXT, on ? 1 : 0);
}

void settings_reset(void)
{
    // Levels measured on the prototype
    s_settings = (settings_t) {
        .edges_per_rev = CONFIG_BXT_EDGES_PER_REV,
        .cal = {
            [LAUNCHER_BLACK] = {
                .rpm_thr_mv = RPM_THR_DEFAULT_MV,
                .load_cal_valid = true,
                .load_empty = 100,
                .load_loaded = 300,
            },
            [LAUNCHER_WHITE] = {
                .rpm_thr_mv = RPM_THR_DEFAULT_MV + RPM_THR_OFFSET_MV,
                .load_cal_valid = true,
                .load_empty = 490,
                .load_loaded = 750,
            },
        },
    };
}

launcher_cal_t *settings_cal(launcher_t launcher)
{
    return &s_settings.cal[launcher == LAUNCHER_WHITE ? LAUNCHER_WHITE : LAUNCHER_BLACK];
}

const char *launcher_name(launcher_t launcher)
{
    return launcher == LAUNCHER_WHITE ? "white" : "black";
}

esp_err_t settings_init(void)
{
    esp_err_t err = nvs_flash_init();
    if (err == ESP_ERR_NVS_NO_FREE_PAGES || err == ESP_ERR_NVS_NEW_VERSION_FOUND) {
        ESP_RETURN_ON_ERROR(nvs_flash_erase(), TAG, "erase");
        err = nvs_flash_init();
    }
    ESP_RETURN_ON_ERROR(err, TAG, "nvs init");

    settings_reset();

    nvs_handle_t h;
    if (nvs_open(NVS_NAMESPACE, NVS_READONLY, &h) != ESP_OK) {
        ESP_LOGI(TAG, "no saved settings, using defaults");
        return ESP_OK;
    }
    uint8_t light_sleep;
    if (nvs_get_u8(h, NVS_KEY_LIGHT_SLEEP, &light_sleep) == ESP_OK) {
        s_light_sleep = light_sleep != 0;
    }
    uint8_t ble;
    if (nvs_get_u8(h, NVS_KEY_BLE, &ble) == ESP_OK) {
        s_ble = ble != 0;
    }
    uint8_t flip;
    if (nvs_get_u8(h, NVS_KEY_FLIP, &flip) == ESP_OK) {
        s_flip = flip != 0;
    }
    uint8_t bbp_ext;
    if (nvs_get_u8(h, NVS_KEY_BBP_EXT, &bbp_ext) == ESP_OK) {
        s_bbp_ext = bbp_ext != 0;
    }
    uint8_t auto_white;
    if (nvs_get_u8(h, NVS_KEY_AUTO_WHITE, &auto_white) == ESP_OK) {
        s_auto_white = auto_white != 0;
    }

    settings_blob_t blob;
    size_t len = sizeof(blob);
    err = nvs_get_blob(h, NVS_KEY, &blob, &len);
    nvs_close(h);

    if (err == ESP_OK && len == sizeof(blob) && blob.version == SETTINGS_VERSION) {
        s_settings = blob.s;
        ESP_LOGI(TAG, "loaded: edges/rev=%u, black thr=%u mV load cal=%s, white thr=%u mV load cal=%s",
                 s_settings.edges_per_rev,
                 s_settings.cal[LAUNCHER_BLACK].rpm_thr_mv,
                 s_settings.cal[LAUNCHER_BLACK].load_cal_valid ? "yes" : "no",
                 s_settings.cal[LAUNCHER_WHITE].rpm_thr_mv,
                 s_settings.cal[LAUNCHER_WHITE].load_cal_valid ? "yes" : "no");
    } else {
        ESP_LOGW(TAG, "saved settings missing or outdated, using defaults");
    }
    return ESP_OK;
}

settings_t *settings_get(void)
{
    return &s_settings;
}

esp_err_t settings_save(void)
{
    settings_blob_t blob = {.version = SETTINGS_VERSION, .s = s_settings};
    nvs_handle_t h;
    ESP_RETURN_ON_ERROR(nvs_open(NVS_NAMESPACE, NVS_READWRITE, &h), TAG, "open");
    esp_err_t err = nvs_set_blob(h, NVS_KEY, &blob, sizeof(blob));
    if (err == ESP_OK) {
        err = nvs_commit(h);
    }
    nvs_close(h);
    return err;
}
