dazchi/bx-tacho/firmware/main/display.h

// SPDX-License-Identifier: GPL-3.0-or-later
// Copyright (C) 2026 Darren Chi
// 128x64 SSD1315 OLED over I2C, drawn from a local framebuffer.
#pragma once

#include <stdbool.h>
#include <stdint.h>
#include "esp_err.h"

#define DISPLAY_W 128
#define DISPLAY_H 64

esp_err_t display_init(void);
bool display_present(void);

void display_clear(void);
// Draw text with the 5x7 font magnified by `scale` (glyph cell = 6*scale wide).
void display_text(int x, int y, const char *s, int scale);
void display_hline(int x0, int x1, int y);
// 1-bit bitmap, row-major, MSB = leftmost pixel, rows padded to whole bytes (see icons.h)
void display_bitmap(int x, int y, int w, int h, const uint8_t *bits);
// Width in pixels of `s` drawn at `scale`
int display_text_width(const char *s, int scale);

esp_err_t display_flush(void);

void display_set_contrast(uint8_t level);
// Turned 180 degrees (both axes mirrored in the controller): takes effect at once
void display_set_flipped(bool flipped);
// Off = display off and charge pump off (lowest current)
void display_power(bool on);
