dazchi/bx-tacho/(commit log)

2026-10-01 Add initial schematic for BX tachometer (rev 1)
    First version of the KiCad schematic for the Beyblade X shooter RPM meter:
    - USB-C connector (5.1k CC pull-downs, VUSB detect divider)
    - Power: TP4054 Li-ion charger, B5819W/AO3401A power-path to VSYS,
    slide power switch, ME6211 3.3V LDO, battery voltage sense divider
    - Sensors: 2x ITR8307 reflective IR sensors with LMV393 comparators
    (PWM-RC thresholds, hysteresis) and a switched PERI_3V3 rail
    - MCU: ESP32-C3-WROOM-02 with EN/BOOT buttons and native USB
    - I2C OLED display, battery connector and test points
    Includes project-local symbol, footprint and 3D model libraries, plus a
    .gitignore for KiCad local history, lock and per-user files.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
2026-10-04 Finalize schematic for review (v0.2)
    Schematic is complete and ready for PCB layout: every net traced, all
    footprints assigned, R16 set to DNP, and PWR_FLAGs on VUSB, GND, +3V3
    and RPM_CMP_PWR. Adds the LMV331 SOT-23-5 footprint and the custom
    symbols it needs, and silences two noisy ERC checks (four_way_junction,
    pin_to_pin) that only fire on expected topologies here.
2026-10-04 Start v0.2 PCB layout and add JLCPCB design rules
    Work-in-progress layout:
    - Import and place all 62 footprints; first routing pass and copper zones
    - Add bx-tacho.kicad_dru with JLCPCB 2-layer, 1 oz fabrication limits
    - Add custom BatteryPads_1x02_SMD_2x3mm_P4mm footprint (two 2x3 mm SMD
    pads, 4 mm pitch) and use it for J1 instead of the solder-wire footprint
    - Export the BOM (bx-tacho.csv) and set up BOM fields in the project
    - Add board-outline DXFs (plain, with mounting holes, with 2 mm mounting
    holes) for the Fusion 360 housing
2026-10-05 Complete v0.2 PCB layout and add fabrication outputs
    Schematic:
    - Remove test points TP1-TP13 and the J3 4-pin header
    - Re-annotate components (reference designators renumbered)
    PCB:
    - Complete routing of all nets (0 unconnected items, schematic parity clean)
    - Add 90ohm_diff net class for USB_DP/USB_DN
    - Add curved teardrops on PTH pads, SMD pads and vias
    - Convert USB1 and U4 mounting holes to NPTH; adjust USB1 GND pad
    position to meet JLC hole-to-copper clearance
    - Tighten zone settings (0.2 mm min width, 0.3 mm thermal gap/spoke)
    - Ignore courtyard-overlap and PTH-in-courtyard checks; exclude
    reviewed silkscreen and USB1 starved-thermal DRC items
    Fabrication:
    - Add Gerber and drill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
2026-10-17 Add ESP-IDF v6.1 firmware for the v0.2 board
    First version of the ESP32-C3 firmware, following HANDOVER.md section 6:
    - RPM channel: power sequencing, 100 kHz threshold PWM (capped at
    2.0 V) and rising-edge timestamp ISR
    - Load sensor: ambient-cancelled ADC readings, calibrated 60/40 %
    hysteresis classifier with baseline tracking
    - Launch state machine (EMPTY/LOADED/PULLING/RESULT), peak RPM as the
    median of the three fastest revolutions, window ended at release
    - Battery voltage, USB presence and charge state
    - SSD1315 OLED via esp_lcd with a 5x7 framebuffer font
    - Calibration stored in NVS
    - Light sleep, display dimming and deep sleep with USB wake-up
    - Bring-up and calibration cons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
2026-10-17 Rework RPM sensor channel and fix layout review findings
    Schematic (bench-validated on the v0.2 prototype, KEY1 = ITR8307/S17):
    - R13 220 -> 100 ohm: more IR LED current
    - R15 10k -> 22k: about 2.2x RPM_SENSE gain
    - R11 1M -> 4.7M: hysteresis about 65 -> 22 mV
    - New C12 2.2 nF across R15 to filter RPM_SENSE noise
    - Place C12 and rearrange C8, R11, R13-R16 around it
    - Move vias out of the R13 and LDO1 pads
    - Strengthen the USB1 GND pad connections (starved thermals)
    - Add teardrops
    - Update DRC exclusions in the project file
    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
2026-10-18 Use 4.7k I2C pull-ups and run the OLED bus at 400 kHz
    Hardware:
    - R21/R22 (OLED SCL/SDA pull-ups) 10k -> 4.7k in schematic and PCB
    - Teardrops regenerated on save; no routing or pour changes
    Firmware:
    - CONFIG_BXT_OLED_I2C_HZ default 100000 -> 400000; help text notes
    that 10k pull-ups still need 100 kHz
    - A full frame now takes about 25 ms instead of about 95 ms
    Tested on the v0.2 prototype with the reworked pull-ups.
2026-10-18 Add relative chatter filter and tune RPM/load defaults
    Chatter filter (launch.c):
    - Besides the CONFIG_BXT_MAX_RPM floor, drop edges that arrive sooner
    than CONFIG_BXT_CHATTER_RATIO_PCT (default 60 %) of the recent edge
    interval; chatter at the opposite transition lands ~50 % in
    - Reference = min(last interval, median of the last 3), active after
    3 intervals so hard starts from rest pass; gaps > 1.7x the reference
    are not learned (missed edge), history clears after a 250 ms stop
    - Count rejected edges per launch, split into max-rpm and relative,
    shown in `status` and the end-of-launch log
    Defaults (used only without saved settings or after `cfg reset`):
    - RPM threshold 1000 -> 70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
2026-10-19 Add meter mode for continuous RPM bench tests
    - New app mode alongside run/diag: `meter on|off` keeps the RPM
    channel powered, pauses the launch state machine and keeps the
    display on
    - Meter screen: last-revolution RPM large, then min/max over the last
    second, the 1 s average and rejected-edge counts (max-rpm/relative)
    - `meter` / `meter log [s] [ms]` print readings as CSV for comparing
    against a reference tachometer or motor
    - Chatter filter moved into a shared accept_edge() so meter mode uses
    the same edge processing as launches
    - `status` shows the current mode and meter readings
2026-10-19 Fix deep sleep and add power-event log and sleep countdown
    Deep sleep fixes:
    - Clear all wake-up sources before deep sleep. Automatic light sleep
    leaves a timer wake-up armed, so deep sleep ended after ~0.7 s and
    the chip rebooted every idle timeout (screen relit, battery drained)
    - Measure idle time from the current time and clamp it at 0. Activity
    noted during a sensor-loop pass made it negative, wrapping to a huge
    value: instant deep sleep on USB unplug, display flicker on activity
    Event log (`events`, `events clear`):
    - Last 48 power events in RTC memory (survives deep sleep and resets,
    not power-on), timestamped on the RTC clock: boots with reset reason
    and wake-up causes,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
2026-10-19 Add low-battery icon screen and SVG-to-bitmap converter
    - Low-battery shutdown shows a dead-battery icon with the battery
    voltage (X.XX V) for 2 s, then a 3 s countdown; plugging in USB at
    any point cancels it so the battery can charge
    - Icon: Tabler Icons "battery-off" (react-icons TbBatteryOff, MIT),
    48x48 1-bit bitmap in icons.c with the Tabler license; source SVG
    kept in assets/icons/
    - tools/svg_icon_to_c.py renders stroked SVG paths (lines and arcs,
    round caps) at 8x and downsamples to a 1-bit C array, with an
    ASCII preview
    - display_bitmap() draws row-major 1-bit bitmaps
2026-10-19 Show live sensor readings on the display in diag mode
    - Diag mode samples the sensors every 100 ms (read only; the console
    still decides what is powered) and keeps the display on
    - Screen: LOAD_SENSE ambient-cancelled value with its % of the
    calibration, plus the raw LED-on and LED-off readings; RPM_SENSE
    (or OFF while the channel is unpowered), the comparator threshold
    and its output level
    - load_measure_raw() returns the raw on/off readings; load_measure()
    now wraps it
    - Font: add [ \ ] ^ _ (the underscore was missing) and a compile-time
    check that the glyph table matches its declared range
2026-10-20 Add boot splash with project icon and firmware version
    - 1 s boot screen: project icon on the left, "BX / TACHO" and the
    firmware version on the right
    - Firmware version set with PROJECT_VER (0.1.0) in CMakeLists.txt,
    read from the app description; `status` shows it with the ESP-IDF
    version
    - Project icon: spinning top seen from above (curved swirl blades,
    gear hub with solid core, motion swooshes), simplified from an
    AI-generated reference image. assets/icons/beyblade.svg is a
    reusable 24x24 monochrome SVG generated by tools/gen_beyblade_icon.py;
    main/icons.c holds the 40x40 bitmap
    - svg_icon_to_c.py: per-path stroke-width and filled shapes
    - assets/icons/README.md lists each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
2026-10-20 Log raw load readings, fix USB/VBAT event timing, bump to 0.1.1
    - LOAD ON/OFF events record the raw LED-on and LED-off readings and
    whether the sample came from a poll or hold-mode read; event entries
    grow to four values plus flags (log magic bumped, so an old-layout
    log is discarded once)
    - USB presence is checked on every sensor-loop pass, so the light-sleep
    lock is taken immediately (the ESP32-C3's USB console does not
    survive light sleep), including right after boot
    - USB ON/OFF events wait for the first battery reading so they carry a
    real VBAT instead of 0 mV after boot; VBAT prints "n/a" if none is
    available. Battery readings start once the divider has settled
    (BATTERY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
2026-10-20 Add production VBAT calibration, bump to 0.2.0
    - `cal vbat start|point <mV>|save|verify <mV>|show|stop`: the board runs
    from a bench supply on J1 with a data-only USB link; each point averages
    8x16 ADC readings after settling and is checked for stability,
    plausibility against the nominal reading and spacing
    - Least-squares line VBAT = gain * pin + offset; rejected unless it spans
    >= 500 mV, gain is 1.9-2.1 (catches a wrong divider resistor), offset
    <= 200 mV and every point is within 15 mV; verify passes within +-10 mV
    - Stored in a new "fctry" NVS partition (partitions.csv; the existing
    partitions keep their offsets, so saved settings survive). `cfg reset`
    and NVS recovery nev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
2026-10-20 Keep the USB console alive on a data-only cable, bump to 0.2.1
    On battery with a data-only USB cable (no VBUS) the firmware allowed
    automatic light sleep, which disables the ESP32-C3's USB pads, so the
    device kept dropping off the bus ("USB device not recognized").
    - Enable CONFIG_USJ_NO_AUTO_LS_ON_CONNECTION: the USB Serial/JTAG driver
    blocks light sleep while a host sends SOF packets, with or without
    VBUS, and releases it within ~3 ms when there is no host
    - Skip the idle deep sleep while a USB host is connected
    - `status` shows VBUS and USB host presence separately
    - Firmware version 0.2.0 -> 0.2.1
2026-10-20 Add status-line battery icons, trust VBAT when charge is complete, bump to 0.2.2
    - Status line: battery icon on the right in every power state. On battery
    it shows the level in 10 % steps next to the percentage; while charging
    a filled battery with a bolt, next to VBAT as X.XV; when the charge is
    complete a filled battery with a check mark, next to FULL. Text is
    drawn 1 px down so it is centred on the 9 px icons.
    - VBAT is valid on battery and in the FULL state; only the charging state
    (charge current lifts the reading) stays untrusted. `status` wording
    updated to match.
2026-10-21 Add Battle Pass (BX-09) emulation over BLE, bump to 0.3.0
    Battle Pass emulation (main/bbp.c, docs/bbp-protocol.md):
    - Advertises as BEYBLADE_TOOL01 with the Battle Pass service on NimBLE;
    status (A0), shot history (B0-B7) and launch curve (70-73) as 17-byte
    notifications; commands 0x51 and 0x74, others logged and ignored
    - Attach/detach status from the load sensor, the shot set after each
    launch; history of 50 shots, lifetime count and max kept in NVS
    - BLE alongside automatic light sleep (modem sleep, main crystal kept on);
    disconnects cleanly before deep sleep
    - Status line: centred BLE icon (off / advertising / connected); LOW is
    drawn closer to the battery percentage
    - Console: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
2026-10-21 Flash the load LED instead of holding it on, bump to 0.4.0
    The load LED's light reflected off a loaded top reaches the RPM sensor:
    held on while a top was loaded and through the pull, it hid RPM edges
    (and could add false ones), which caused half-speed readings and filter
    locks early in pulls.
    - Load samples while the RPM channel is armed use a ~0.4 ms LED flash
    (ambient read, LED on, 400 us settle, read, LED off)
    - Flashes only in the first 40 % of the shortest of the last three edge
    intervals, at most 8 ms after an edge, never while an edge is overdue;
    every 10 ms while the disc is still. The RPM interrupt wakes the
    sensor task so flashes start right after an edge
    - rpm.c drops ed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
2026-10-21 Stop load LED flashes after the release, bump to 0.4.1
    Once the load sensor has seen the release, a launch needs no more load
    readings until it ends: no flashes during the spin-down. Normal
    sampling resumes when the launch ends (RESULT). A top held on through
    the launch is never released, so its flashes continue as before.
2026-10-21 Switch BLE on/off with a load-sensor gesture, bump to 0.5.0
    - Five loads in a row (top on, off, on, ...), each within 1.5 s of the
    previous one, flip the saved BLE setting; loads during a pull don't
    count
    - The display shows BLE ON / BLE OFF and RESTARTING for 1.5 s, the app
    is disconnected, then BX Tacho restarts to apply it (as 'ble on|off')
    - Logged as BLE GESTURE in the event log; README documents the gesture
2026-10-22 Keep console line editing on over USB
    The console asks the terminal once, at boot, whether it handles escape
    sequences, and falls back to plain line mode for good if nothing answers.
    Over USB nothing is attached that early, so arrow keys printed "[A" and
    the "does not support escape sequences" warning appeared after a restart.
    Force line editing and history on; the web app, idf.py monitor and
    PuTTY all handle escape sequences.
2026-10-22 Add the BX Tacho web app, published to GitHub Pages, bump to 0.6.0
    A static page in web/ (no build step), deployed by
    .github/workflows/pages.yml whenever web/ changes on master.
    USB (Web Serial):
    - Console in an xterm.js terminal, with buttons for common commands
    - Firmware update with esptool-js: only BX Tacho app images
    (bx-tacho.bin, ESP32-C3, project name "bx-tacho") are accepted, written
    at 0x10000 so history and settings are kept. Advanced option to erase
    the whole chip first, which also writes the bundled bootloader and
    partition table, with a red warning that the battery calibration data
    is lost. Resets the chip with an RTS pulse after writing (esptool-js'
    own hard rese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
2026-10-22 Run the console over Bluetooth from the web app, bump to 0.7.0
    Firmware (main/ble_console.c, protocol in ble_console.h):
    - A GATT service of its own beside the Battle Pass one: command lines on
    RX, output notified on TX, a ready byte after each command
    - Locked on every connection until the 6-digit code shown on the display
    (BLUETOOTH CONSOLE) is entered; a wrong code gets a new one after 1 s,
    a code expires after 2 minutes. No Bluetooth pairing, nothing stored
    - Commands print with cli_printf(), which goes to the console running
    them (picolibc's stdout is shared by all tasks); one command at a time
    over USB and Bluetooth, the other one gets a "busy" note
    - Ctrl-C stops meter log,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
2026-10-22 Update the firmware over Bluetooth from the web app, bump to 0.8.0
    Flash layout (partitions.csv): two app slots, ota_0 where the single app
    was and ota_1, with otadata (which one boots) in the last 8 KB below fctry.
    nvs, phy_init and fctry keep their offsets, so settings, history and both
    calibrations survive the switch, and the merged image still ends below
    fctry.
    Firmware (main/ble_ota.c, protocol in ble_ota.h):
    - A GATT service of its own; accepted only while the console is unlocked
    with the code on the display, and on battery only above 50 %
    - The image goes to the idle slot in order, with a window of acknowledged
    bytes; it boots only after ESP-IDF's image check and a project name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
2026-10-22 Show a credit screen after the boot screen, add lowercase, bump to 0.9.0
    - A second boot screen for 1 s: MADE BY / DAZCHI / github.com/dazchi
    - The OLED font covers all printable ASCII: lowercase a-z and ` { | } ~
    are new, and lowercase is no longer drawn as uppercase. g j p q y hang
    one row below the baseline (bit 7 of each column, now drawn); the
    existing screens use capitals only and look the same
    - web/js/font5x7.js regenerated from it; the page draws only capitals and
    digits with it, so nothing changes there
2026-10-22 License BX Tacho under the GPL, version 3 or later
    - LICENSE: the GPL-3.0 text as published by the FSF
    - NOTICE: copyright, the GPL notice, and the parts under other terms:
    the Tabler "battery-off" icon (MIT), imported footprints, symbols and
    3D models in hardware/lib.* (their libraries' terms), the AI-generated
    reference image and the site icons cropped from it, and the ESP-IDF
    bootloader binary in web/firmware (Apache-2.0); plus the outside
    libraries the firmware and web app use, and a trademark note
    - An SPDX line and copyright notice at the top of each source file
    (icons.c: GPL-3.0-or-later AND MIT); gen-font.py writes them into
    web/js/font5x7.js
    - A License section in the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
2026-10-23 Scroll the consoles with a finger on phones
    xterm.js scrolls with the mouse wheel but not with touch, so on a phone a
    drag over either console moved the page instead. A vertical drag now
    scrolls the output while there is more of it that way; past the top or
    bottom, or with nothing to scroll, it moves the page as before.
2026-10-23 Turn the display 180 degrees for left-handed use, bump to 1.0.0
    - cfg flip on|off turns the OLED 180 degrees (both axes mirrored in the
    controller), at once and at every boot before the boot screen; saved in
    NVS like lightsleep and ble, kept by cfg reset; shown by status
    - The console's readable value ends in " flip" while it's on, so the web
    app can show the setting
    Web app: a Display switch (Normal / Left-handed) above the quick commands
    in both consoles. Over USB it sends cfg flip through the console; over
    Bluetooth it shows the setting on connecting, and asks for the code on
    the display first if the console is locked. Strings in all four
    languages.
    Also: settings.c save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
2026-10-23 Show the chip's serial number and Bluetooth address, bump to 1.1.0
    - id: the serial number (factory MAC from eFuse, unique per chip), the
    Bluetooth address, the optional 128-bit eFuse unique ID (or that it
    isn't programmed) and the chip revision
    - The idle screen shows the Bluetooth address bottom right while nothing
    has been measured yet and BLE is on, to tell boards apart in an app's
    device list
    - The console's readable value carries the Bluetooth address too, since
    macOS never gives apps a device's real one; the web app's Bluetooth tab
    shows "BX Tacho <address> · firmware v<version>" once connected (the
    version only, with older firmware)
2026-10-24 Add LCSC part numbers for JLCPCB assembly
    - LCSC field on every assembled part (47 of 50; J1/J2 hand-soldered,
    R18 DNP); D1 is now C8598 (JSCJ B5819W SL, JLCPCB Basic), with its
    value, MPN, manufacturer and old LCSC Part field updated to match in
    the schematic and the PCB
    - Zones refilled (teardrops regenerated)
    - Project DRC settings: silk-over-copper and library-footprint mismatch
    ignored, solder mask to copper clearance 0.005 mm, two stale
    starved-thermal exclusions removed
2026-10-24 Stop tracking the BOM and gerber exports
    Fabrication outputs are published as GitHub Release assets instead. The
    BOM export and the old gerbers are removed from the repo (local copies
    are kept) and ignored, together with the interactive BOM and the JLCPCB
    tools' output folder.
2026-10-24 Add a project README in English and Traditional Chinese, with the assembly animation and schematic
2026-10-25 Calibrate black and white launchers separately, bump to 2.0.0
    - Each launcher kind keeps its own load levels and RPM threshold. BX Tacho
    starts on the black launcher's; a reading above the white launcher's
    loaded threshold switches to white, one below the black launcher's
    released threshold back to black (4 readings, never during a launch).
    A switch counts as a new load, so a top put on a white launcher that read
    as loaded on the black settings still arms the launch.
    - cal load and rpm thr/scan take an optional black|white; status, the diag
    screen and the event log show the launcher in use.
    - Load flash: 800 us settle (400 us read 75 % of the polled level on a black
    launcher, s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
2026-10-25 Flash the load LED at each rising RPM edge, name the launcher in calibration commands, bump to 2.1.0
    - While the disc turns, the load LED flash starts in the RPM edge interrupt
    (ambient reading, LED on) and a GPTimer alarm ends it (reading, LED off at
    once), within 90 % of the disc's white part (half the latest accepted edge
    interval). Its light can then only add to an already high RPM signal, so
    it can't make or move a rising edge. Settling is cut to fit, down to
    600 us, else that edge is skipped; a flash held up past the deadline is
    dropped and counted in status. The 40 % zone scheduler is gone; with the
    disc still the task still flashes every 10 ms with edges masked.
    - The i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
2026-10-26 Freeze the display while a VBAT calibration point is measured, bump to 2.2.0
2026-10-26 Hold readings for 3 s before switching to the white launcher, add cfg autowhite, bump to 2.3.0
    - A switch to the white launcher needs readings above its loaded threshold
    for 3 s without a break: a bey pushed in too far on a black launcher lifts
    the pin past it for a moment before it drops back.
    - cfg autowhite on|off: automatic white launcher detection (default on); off
    always uses the black launcher's settings. Saved like cfg flip.
    - Defaults: RPM threshold 80 mV (white 90 mV), white loaded level 750 mV.
    - The versioned and merged images depend on ESP-IDF's .bin_timestamp, so a
    fresh build directory builds in one run.
